leftger/6UAP-Mata-Spring-2016/README.md

# 6UAP-Mata-Spring-2016
MIT 6UAP Spring 2016 Project Files
Gerzain Mata
