leftger/6UAP-Mata-Spring-2016/uap_final_report/appb.tex

\chapter{Figures}

\vspace*{-3in}

\begin{figure}[htp]
\begin{center}
\vspace{2.4in}
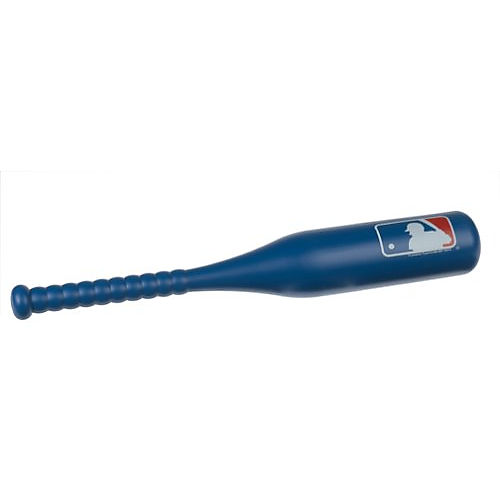
[picture p3: uap_final_report/jumbo_bat.jpg]

\caption{The bat used as an enclosure}
\label{fig:jumbo_bat}
\end{center}
\end{figure}
\clearpage
\newpage

\begin{figure}[htp]
\begin{center}
\vspace{0.4in}
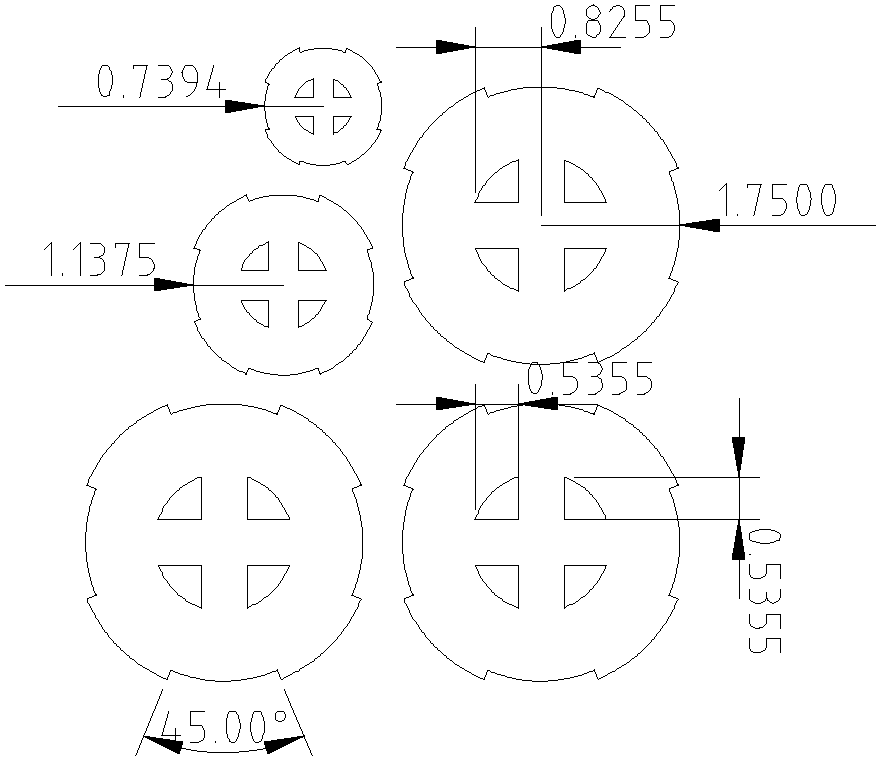
[picture p4: uap_final_report/supports.png]

\caption{CAD design and dimensions for bat internal supports}
\label{fig:supports}
\end{center}
\end{figure}
\clearpage
\newpage

\begin{figure}[htp]
\begin{center}
\vspace{0.4in}

\caption{Hardware Overview}
\label{fig:hardware_overview}
\end{center}
\end{figure}
\clearpage
\newpage

\begin{figure}[htp]
\begin{center}
\vspace{0.4in}

\caption{State Machine representation of software}
\label{fig:state_machine}
\end{center}
\end{figure}
\clearpage
\newpage

\begin{figure}[htp]
\begin{center}
\vspace{0.4in}
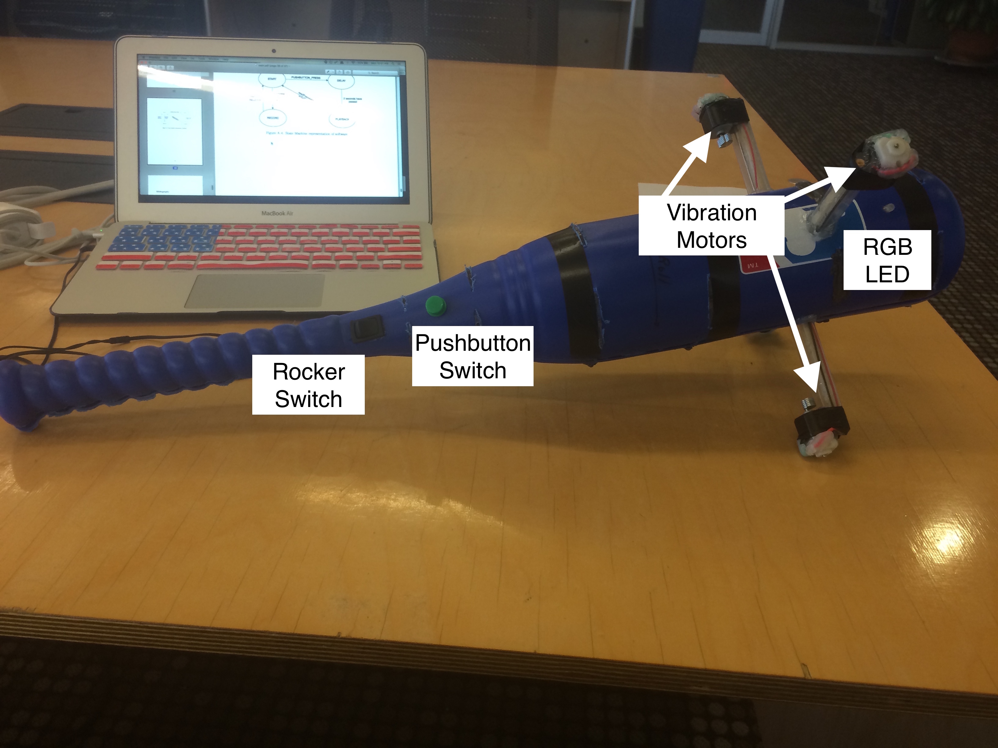
[picture p5: uap_final_report/bat_front.JPG]

\caption{Outside view of apparatus}
\label{fig:bat_front}
\end{center}
\end{figure}

\begin{figure}[htp]
\begin{center}
\vspace{0.4in}
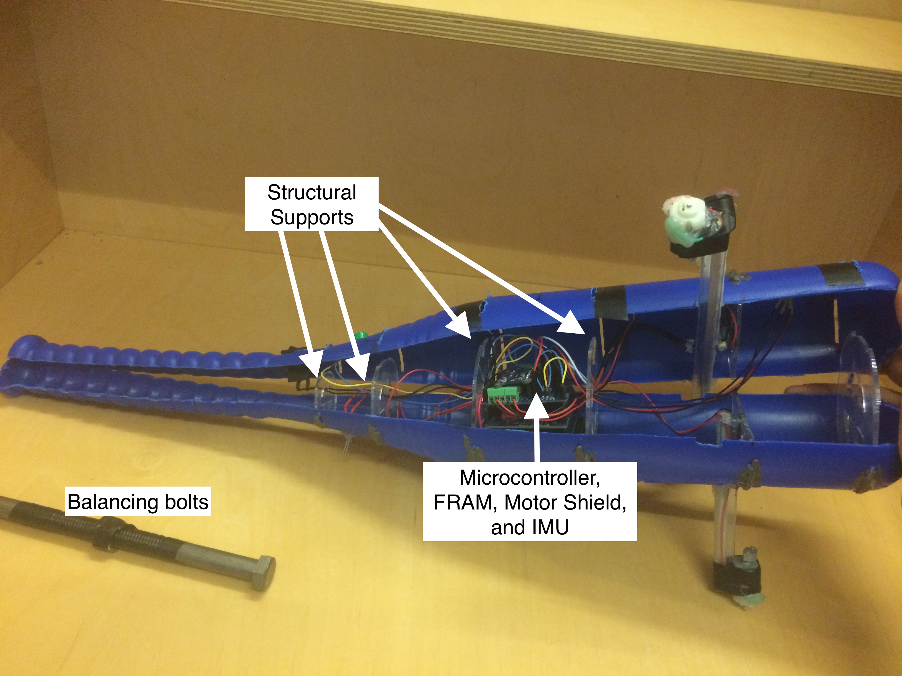
[picture p6: uap_final_report/bat_inside.JPG]

\caption{Inside of apparatus and hardware}
\label{fig:bat_inside}
\end{center}
\end{figure}
\clearpage
\newpage
