leftger/6UAP-Mata-Spring-2016/#supports.dxf

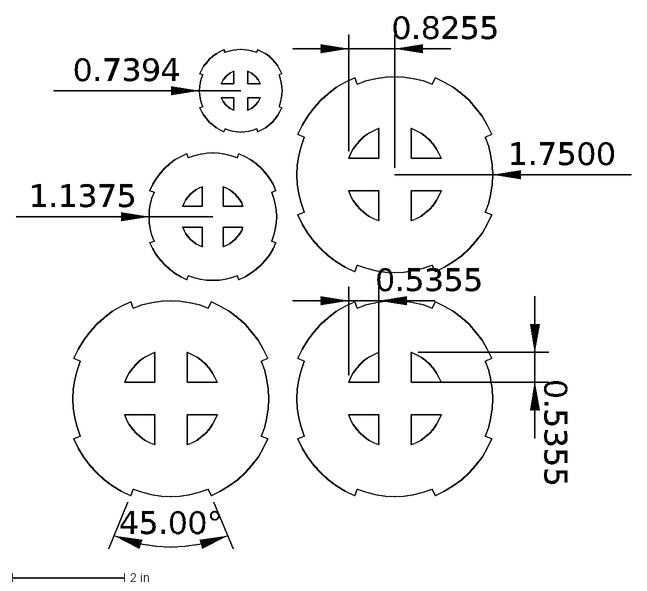
[picture p7: CAD file, 2016-05-11]
#supports.dxf
1.7500
0.7394
1.1375
0.5355
0.8255
45.00°
