leftger/6UAP-Mata-Spring-2016/(list of files, cad)

Other CAD files:
supports.dxf
