leftger/6UAP-Mata-Spring-2016/(commit log)

2016-04-10 added FRAM library folder and added some functions to hopefully drive motors at a given theta
2016-04-11 added AdaFruit 9DOF IMU libraries and some code
2016-04-28 added IMU libraries and have simple feedback for roll at 0
2016-05-04 removed FRAM sample project
2016-05-05 found Madgwick header file. Took out 100msec delay so sampling rate is now ~90Hz
2016-05-06 took out pressure sensor. LEDs work
2016-05-06 added pushbutton and rocker switch states. ISRs might need work
2016-05-11 fixed error deriv calculation
    [project_files.ino]
2016-05-11 added a ton of files. Mostly writeups
    [#supports.dxf, supports.dxf]
